zemli777/code_lock/A3_vremennye_diagrammy.pdf

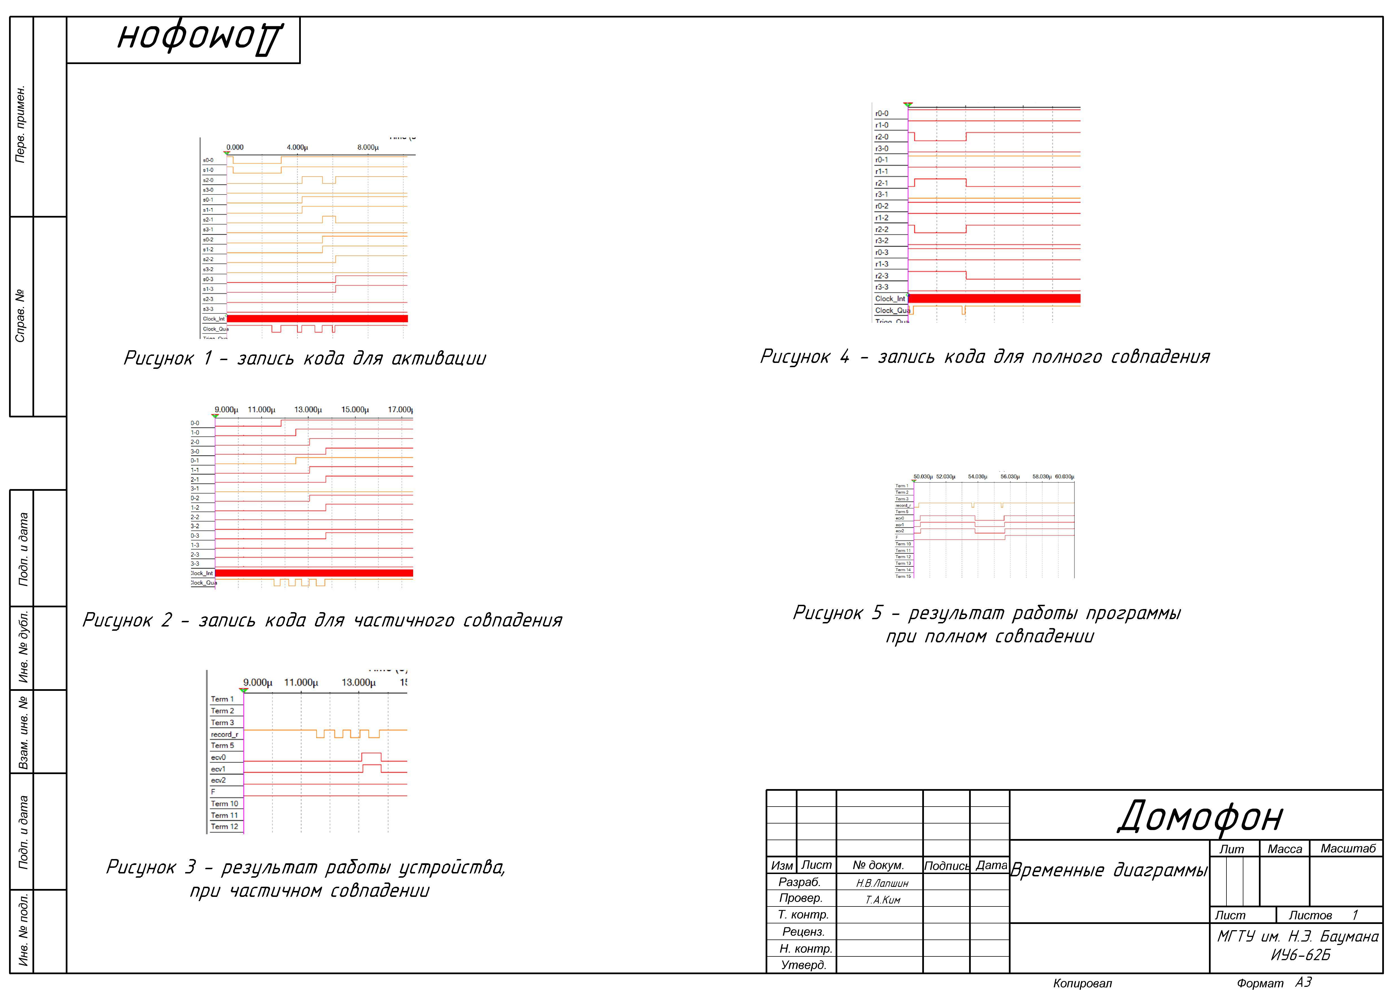
[picture p1: page 1]
