zemli777/code_lock/спецификация_2.pdf

Изм. | Лист | № докум | Подпись | Дата
| | Разраб. | | | Спецификация. Сборочный чертеж. | Литера | Лист | Листов
Пров. | | | | | Т | | 1 | 1
R1 | МЛТ 0,125 - 0,56 кОм | 1
R2,R3 | МЛТ 0,125 - 0,22 кОм | 2
R4 | МЛТ 0,125 - 1,8 кОм | 1
R5 | МЛТ 0,125 - 1 кОм | 1

МГТУ им. Н.Э. Баумана
каф. ИУ6
Группа ИУ6-65Б

## Домофон

Разьемы

XP1 | SP2112/P6 | 1
XP2 | SP2112/P2 | 1

Кол.

| Обозначение | Наименование | | Приме-чание
| | Документация
| | Схема электрическая | 1
А3 | | функциональная
| | Схема электрическая | 1
А2 | | принципиальная
| | Временные диаграммы | 1

Формат
Зона
Поз.

А3

Утв.

С1 | К50-68-25-10мкФ ГОСТ 5-635-70 | 1
С2-C9 | КМ5Б-Н90-0,1мкФ ГОСТ 5-621-70 | 8
DD1 | К555ЛН1 | 1
DD2,DD3 | К555ТМ2 | 2
DD4-DD6,DD8,DD9,DD11,DD12,DD14 | К555ТМ8 | 8
DD7,DD10,DD13,DD15 | К555СП1 | 4

Резисторы

Микросхемы

Конденсаторы

Взам. инв. № Инв. № подл Подп. и дата

Инв. № дубл. Подп. и дата
