zemli777/code_lock/принципиальная.png

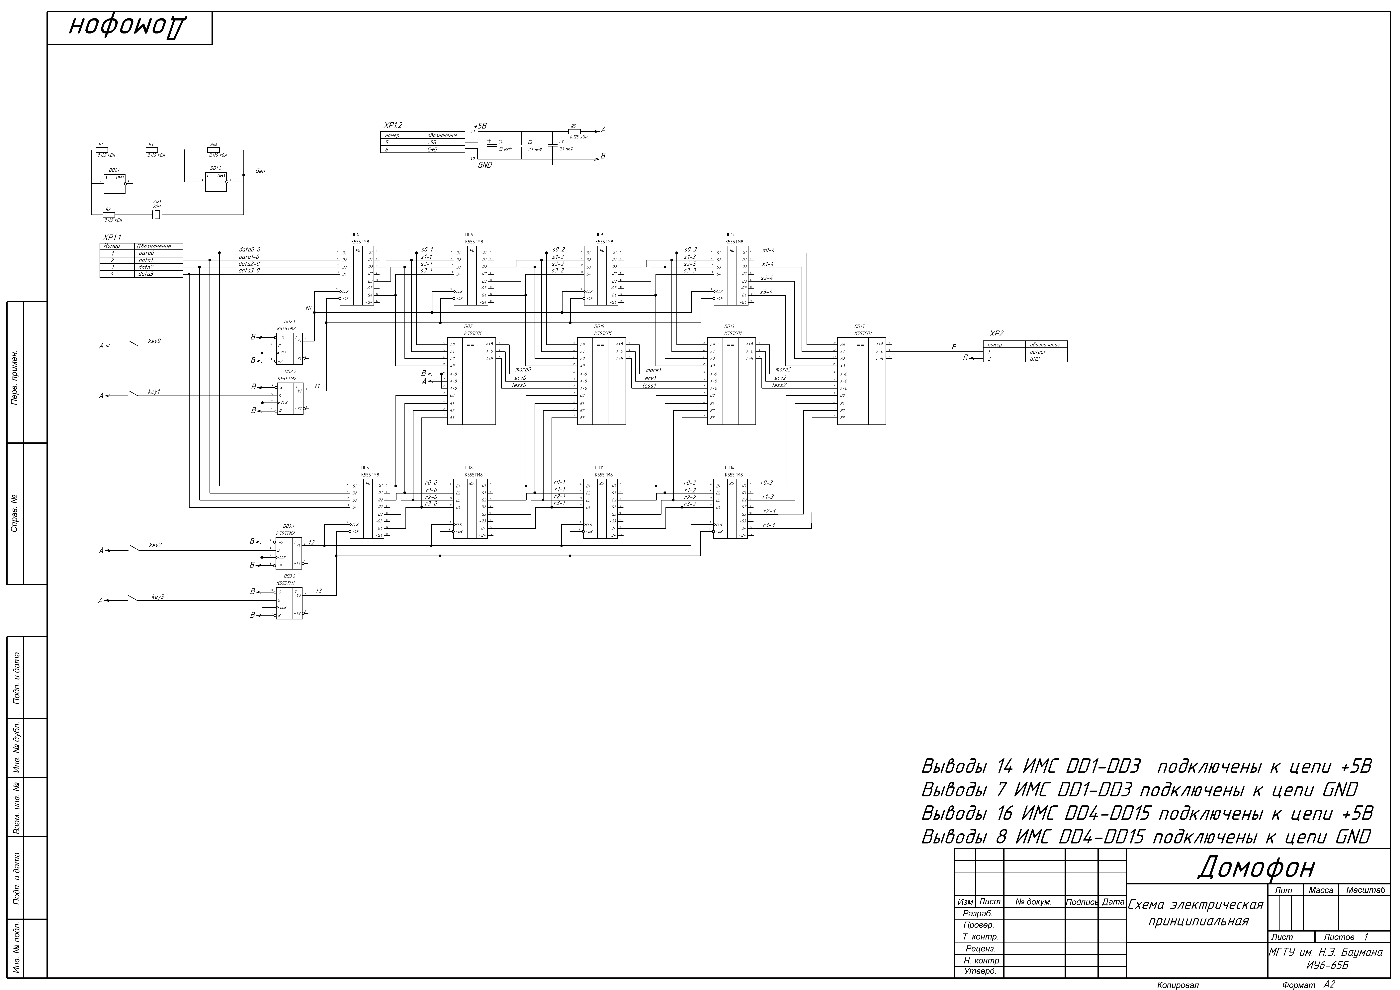
принципиальная.png
