zemli777/code_lock/функциональная.png

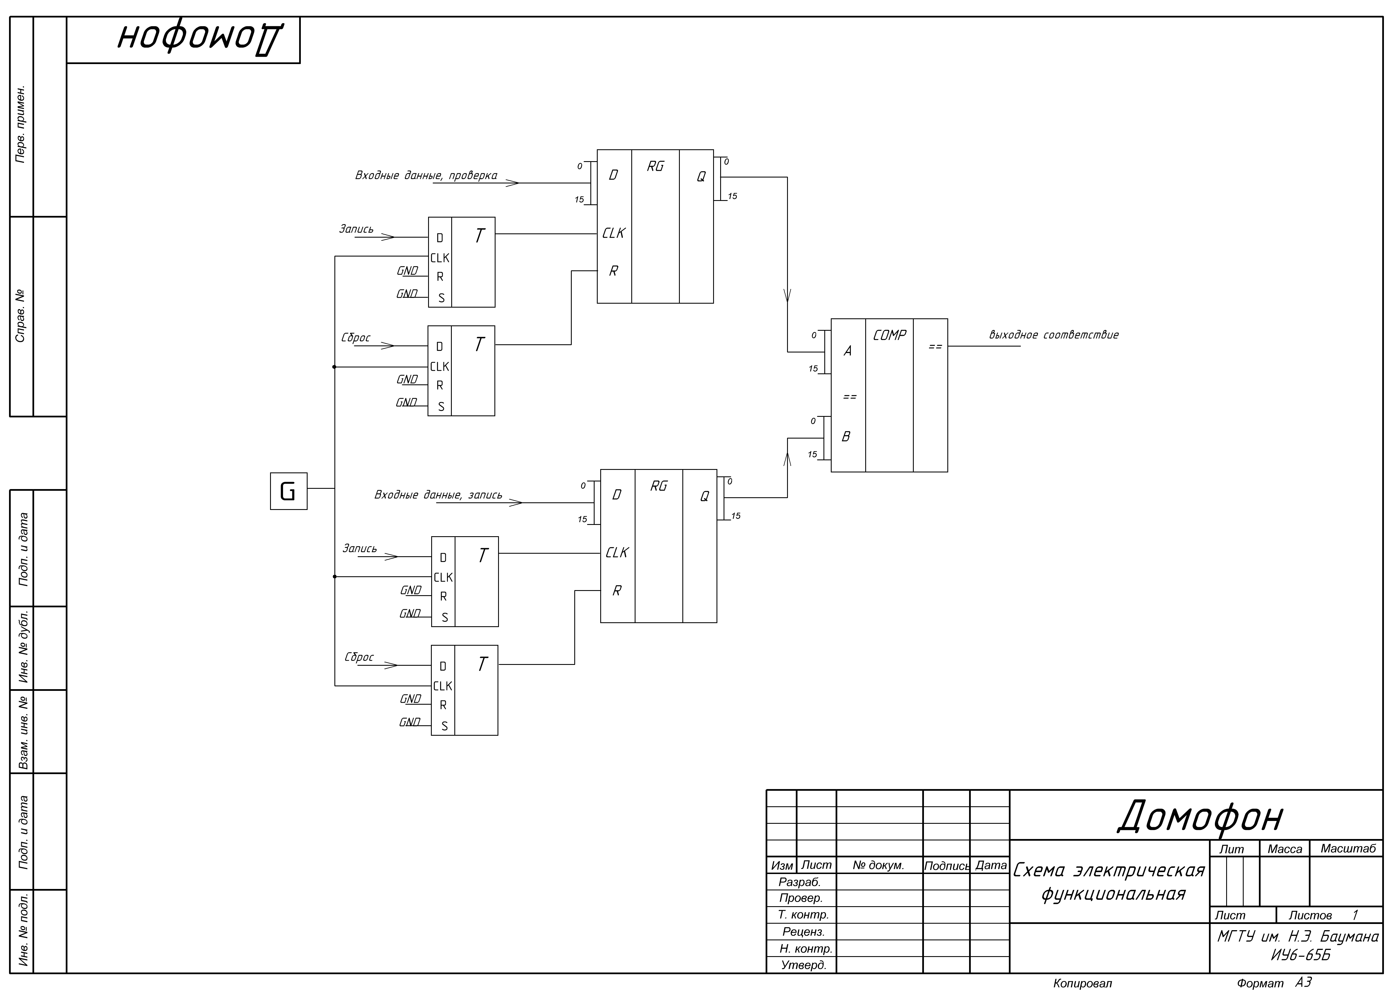
функциональная.png
