zemli777/code_lock/(list of files, drawings)

Other design files:
kurs_v1.ms12
